mtabini/Site3ELS/Mechanical/Control Panel.step

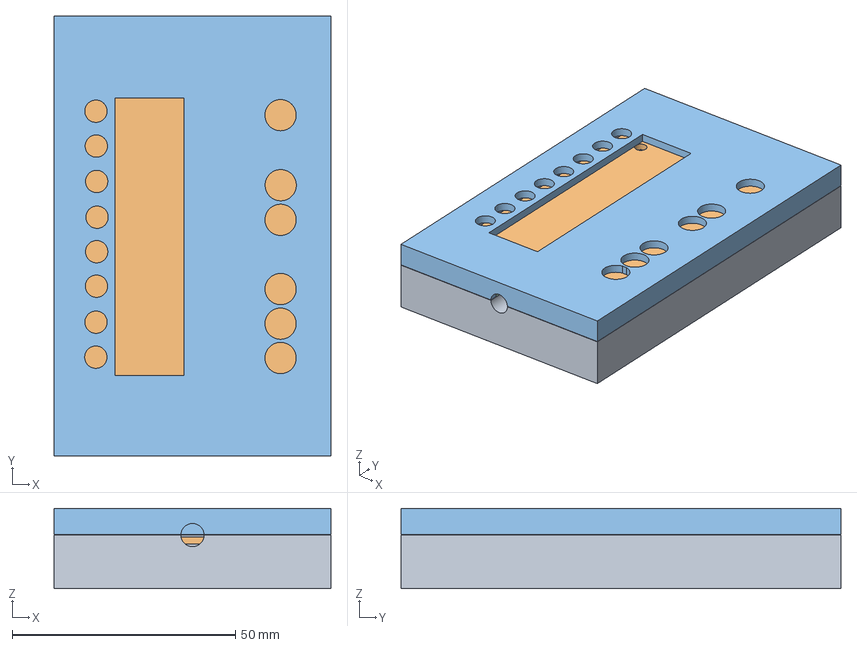
[picture p1: CAD file, 2024-11-28]
Mechanical/Control Panel.step
62.0 x 98.5 x 18.0 mm
