mtabini/Site3ELS/Mechanical/Protoboard enclosure.step

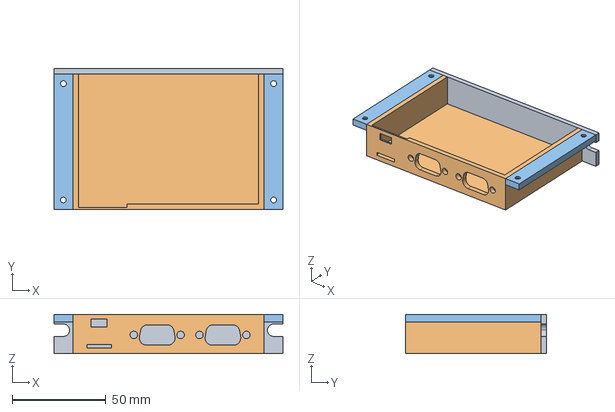
[picture p2: CAD file, 2024-11-28]
Mechanical/Protoboard enclosure.step
122.0 x 75.0 x 21.0 mm
