mtabini/Site3ELS/Hardware/Protoboard/Electronic Leadscrew.kicad_pcb

## KiCad design Hardware/Protoboard/Electronic Leadscrew.kicad_pcb (2024-11-28)

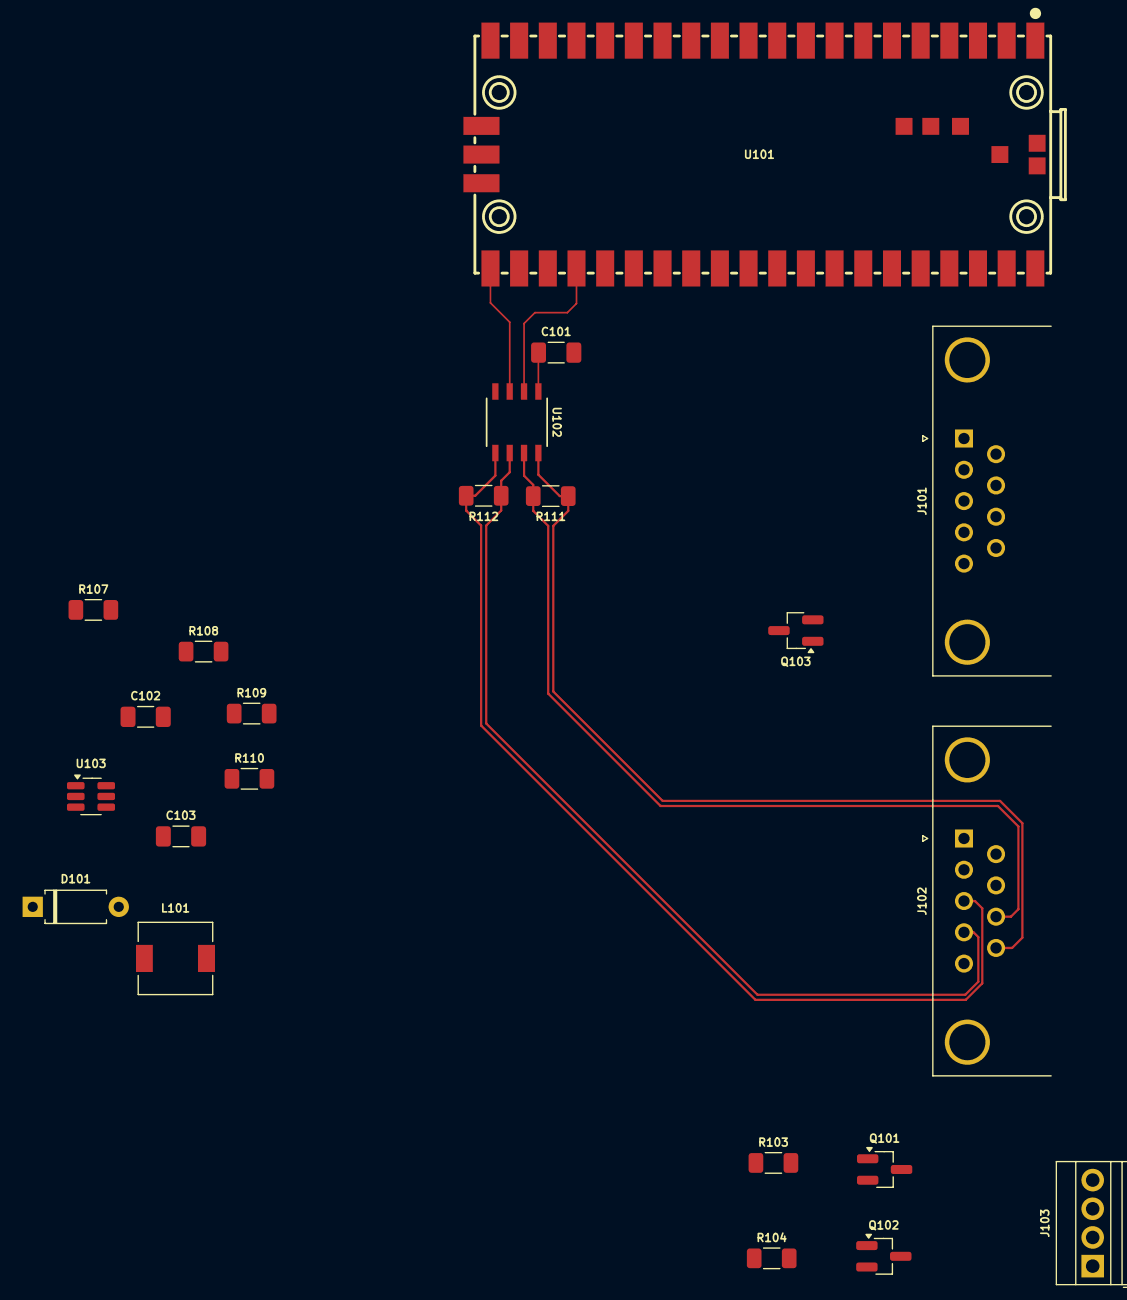
[picture p5: board Hardware/Protoboard/Electronic Leadscrew.kicad_pcb from above]

Board: 2 copper layers, 22 parts (0 on the bottom side), 25 nets.

Parts:
C101: 100n; C_1206_3216Metric_Pad1.33x1.80mm_HandSolder
C102, C103: 22µ; C_1206_3216Metric_Pad1.33x1.80mm_HandSolder
D101: 1N5819; D_A-405_P7.62mm_Horizontal
J101: DISPLAY; DSUB-9_Female_Horizontal_P2.77x2.84mm_EdgePinOffset4.94mm_H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
J102: ENCODER; DSUB-9_Female_Horizontal_P2.77x2.84mm_EdgePinOffset4.94mm_H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
J103: STEPPER DRIVER; TerminalBlock_Xinya_XY308-2.54-4P_1x04_P2.54mm_Horizontal
L101: 10µ; L_6.3x6.3_H3
Q101, Q102, Q103: SI2302; SOT-23_Handsoldering
R103, R104: 100R; R_1206_3216Metric_Pad1.30x1.75mm_HandSolder
R107, R108, R109: 10k; R_1206_3216Metric_Pad1.30x1.75mm_HandSolder
R110: 1k; R_1206_3216Metric_Pad1.30x1.75mm_HandSolder
R111, R112: 120R; R_1206_3216Metric_Pad1.30x1.75mm_HandSolder
U101: PI PICO; COMM-SMD_L51.0-W21.0-P2.54_SC0916
U102: TPT480L1-SO1R; SO1SOP-8-A_TPK
U103: SDB628; SOT-23-6_Handsoldering

Connections:
+3.3V: C101.1, J101.6, U101.36 (3V3(OUT)), U102.1 (VCC)
+5V: C102.1, L101.1, R107.1, U101.40 (VBUS), U103.5 (VIN)
+12V: C103.1, D101.1 (K), J102.1, R108.1
/DIS_CLK: J101.3, U101.32 (GP27)
/DIS_DIO: J101.8, U101.34 (GP28)
/DIS_STB: J101.7, U101.31 (GP26)
/ENC_CLK: U101.21 (GP16), U102.3 (D)
/ENC_CLK+: J102.3, R112.1, U102.5 (Y)
/ENC_CLK-: J102.4, R112.2, U102.6 (Z)
/ENC_DAT: U101.24 (GP18), U102.2 (R)
/ENC_DAT+: J102.9, R111.1, U102.8 (A)
/ENC_DAT-: J102.8, R111.2, U102.7 (B)
/STP_DIR-: J103.4, Q101.3 (D)
/STP_PUL-: J103.2, Q102.3 (D)
/~ENC_STAT: J102.5, Q103.1 (G)
GND: C101.2, C102.2, C103.2, J101.2, J102.2, Q101.2 (S), Q102.2 (S), Q103.2 (S), R110.2, U101.3 (GND), U101.8 (GND), U101.13 (GND), U101.18 (GND), U101.23 (GND), U101.28 (GND), U101.33 (GND), U101.38 (GND), U102.4 (GND), U103.2 (GND)
unnamed: D101.2 (A), L101.2, U103.1 (VOUT)
unnamed: Q101.1 (G), R103.2
unnamed: Q102.1 (G), R104.2
unnamed: Q103.3 (D), U101.29 (GP22)
unnamed: R108.2, R109.1
unnamed: R104.1, U101.26 (GP20)
unnamed: R103.1, U101.27 (GP21)
unnamed: R107.2, U103.4 (EN)
unnamed: R109.2, R110.1, U103.3 (FB)
