mtabini/Site3ELS/(commit log)

2024-11-28 Initial commt
    [Control Panel.step, Electronic Leadscrew.kicad_pcb, Electronic Leadscrew.kicad_sch, Protoboard enclosure.step, bom.csv, designators.csv, positions.csv]
2024-11-28 Update schematics
2025-01-23 Update PCB
    [Electronic Leadscrew.kicad_pcb, Electronic Leadscrew.kicad_sch, bom.csv, positions.csv]
2025-02-22 Refactor display speed handling and update configuration for stepper pins
